m47eus2/m47Board-H503/m47Board-H503.kicad_pcb

## KiCad design m47Board-H503.kicad_pcb (2026-09-05)

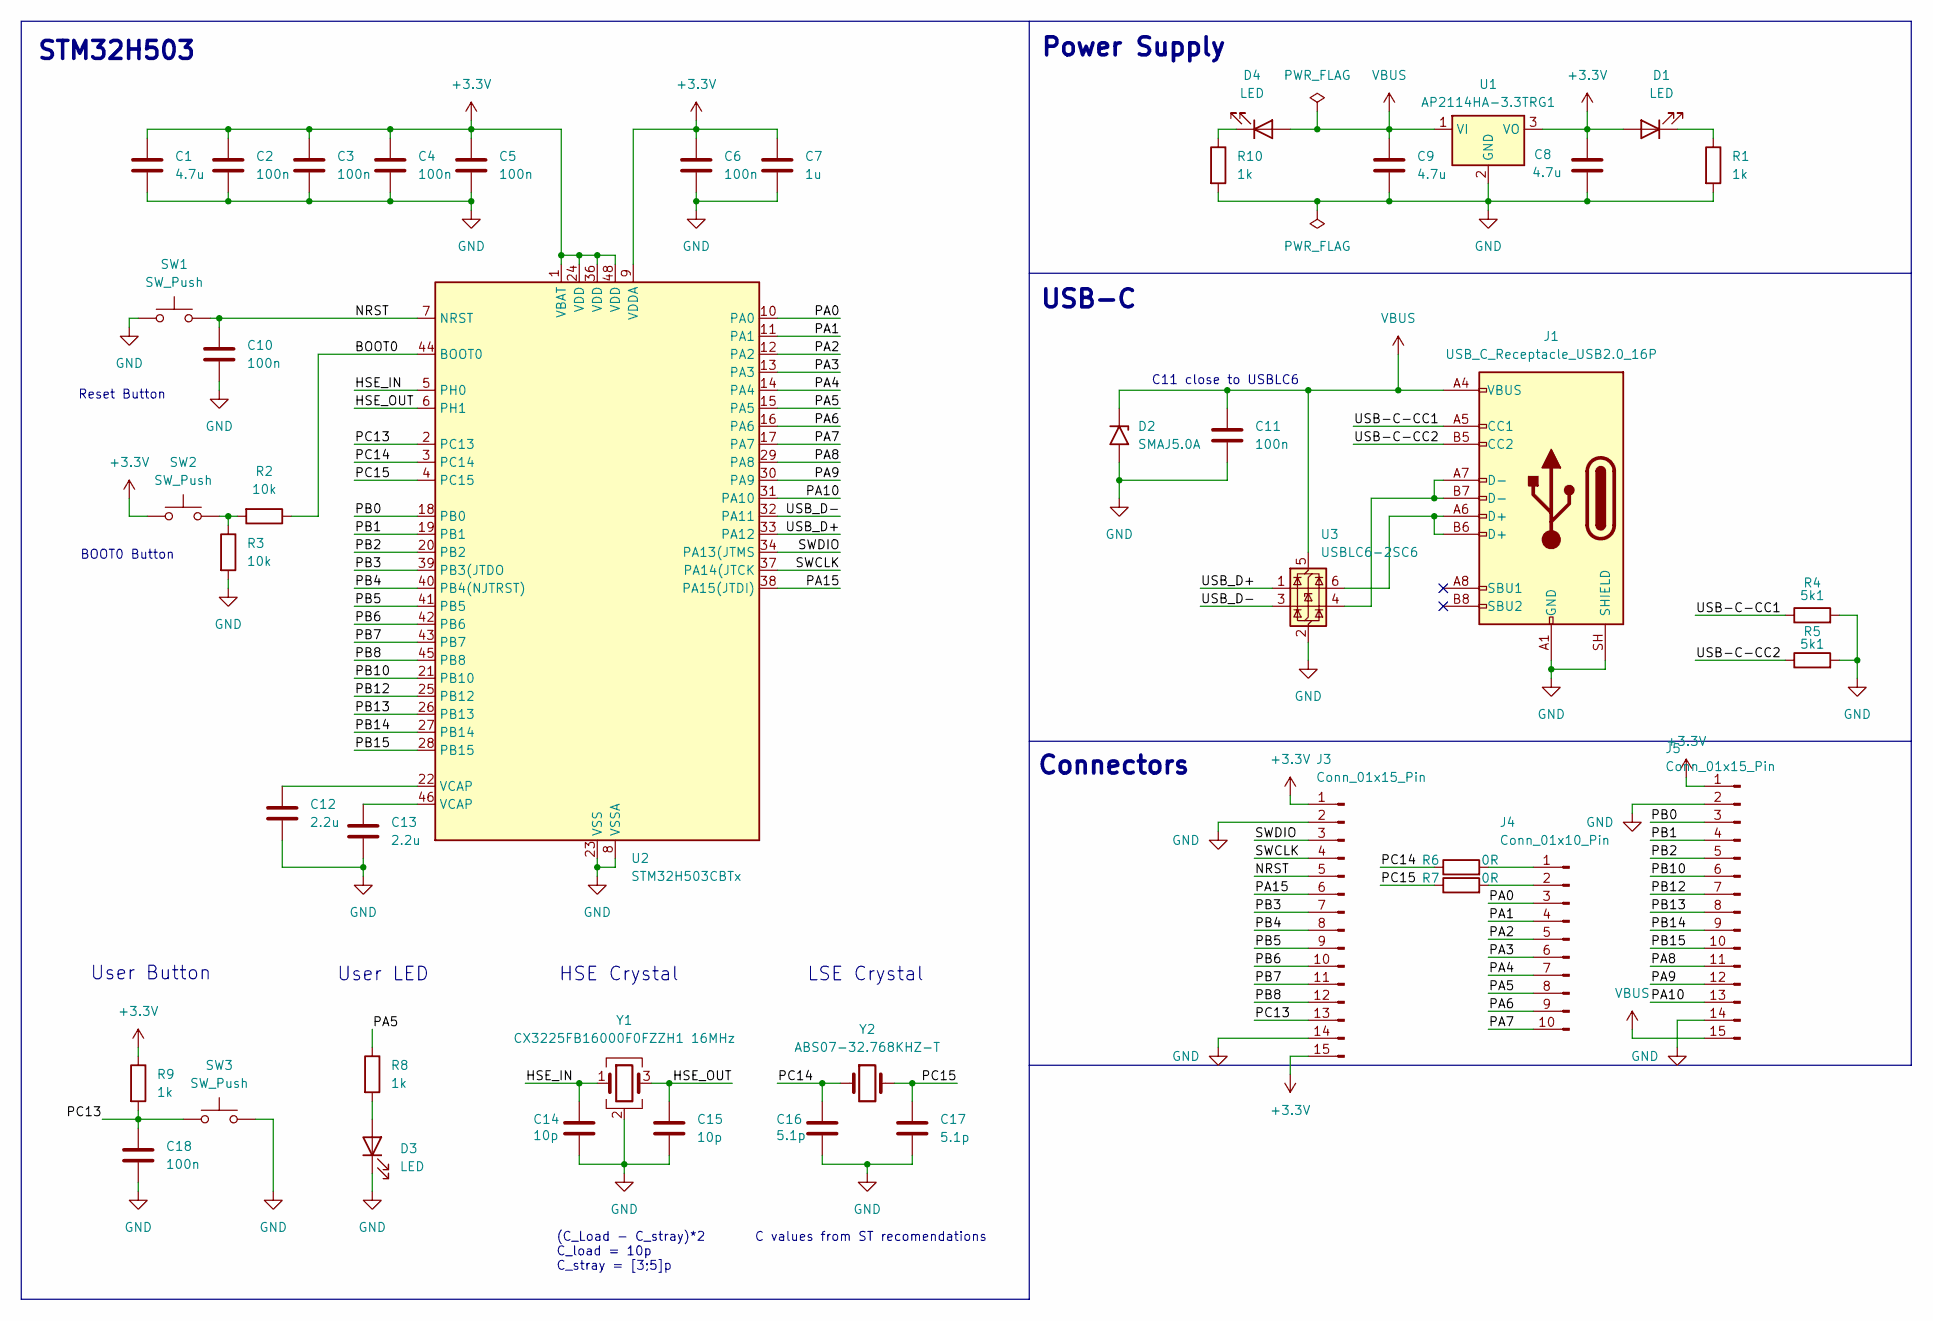
[picture p3: schematic m47Board-H503.kicad_sch]

Parts:
C1, C8, C9: 4.7u; C_0805_2012Metric_Pad1.18x1.45mm_HandSolder
C2, C3, C4, C5, C6, C10, C11, C18: 100n; C_0402_1005Metric_Pad0.74x0.62mm_HandSolder
C7: 1u; C_0603_1608Metric_Pad1.08x0.95mm_HandSolder
C12, C13: 2.2u; C_0603_1608Metric_Pad1.08x0.95mm_HandSolder
C14, C15: 10p; C_0402_1005Metric_Pad0.74x0.62mm_HandSolder
C16, C17: 5.1p; C_0402_1005Metric_Pad0.74x0.62mm_HandSolder
D1, D3, D4: LED; LED_0805_2012Metric_Pad1.15x1.40mm_HandSolder
D2: SMAJ5.0A; D_SMA
J1: USB_C_Receptacle_USB2.0_16P; USB_C_Receptacle_GCT_USB4105-xx-A_16P_TopMnt_Horizontal
J3, J5: Conn_01x15_Pin; PinHeader_1x15_P2.54mm_Vertical
J4: Conn_01x10_Pin; PinHeader_1x10_P2.54mm_Vertical
R1, R8, R9, R10: 1k; R_0402_1005Metric_Pad0.72x0.64mm_HandSolder
R2, R3: 10k; R_0402_1005Metric_Pad0.72x0.64mm_HandSolder
R4, R5: 5k1; R_0402_1005Metric_Pad0.72x0.64mm_HandSolder
R6, R7: 0R; R_0402_1005Metric_Pad0.72x0.64mm_HandSolder
SW1, SW2, SW3: SW_Push; SW_Push_1P1T_NO_E-Switch_TL3301NxxxxxG
U1: AP2114HA-3.3TRG1; SOT-223-3_TabPin2
U2: STM32H503CBTx; LQFP-48_7x7mm_P0.5mm
U3: USBLC6-2SC6; SOT-23-6
Y1: CX3225FB16000F0FZZH1 16MHz; Crystal_SMD_3225-4Pin_3.2x2.5mm
Y2: ABS07-32.768KHZ-T; Crystal_SMD_3215-2Pin_3.2x1.5mm

Connections:
+3.3V: C1.1, C2.1, C3.1, C4.1, C5.1, C6.1, C7.1, C8.1, D1.2 (A), J3.1, J3.15, J5.1, R9.1, SW2.1, U1.3 (VO), U2.1 (VBAT), U2.9 (VDDA), U2.24 (VDD), U2.36 (VDD), U2.48 (VDD)
/BOOT0: R2.1, U2.44 (BOOT0)
/HSE_IN: C14.1, U2.5 (PH0), Y1.1
/HSE_OUT: C15.1, U2.6 (PH1), Y1.3
/NRST: C10.1, J3.5, SW1.2, U2.7 (NRST)
/PA0: J4.3, U2.10 (PA0)
/PA1: J4.4, U2.11 (PA1)
/PA2: J4.5, U2.12 (PA2)
/PA3: J4.6, U2.13 (PA3)
/PA4: J4.7, U2.14 (PA4)
/PA5: J4.8, R8.1, U2.15 (PA5)
/PA6: J4.9, U2.16 (PA6)
/PA7: J4.10, U2.17 (PA7)
/PA8: J5.11, U2.29 (PA8)
/PA9: J5.12, U2.30 (PA9)
/PA10: J5.13, U2.31 (PA10)
/PA15: J3.6, U2.38 (PA15(JTDI))
/PB0: J5.3, U2.18 (PB0)
/PB1: J5.4, U2.19 (PB1)
/PB2: J5.5, U2.20 (PB2)
/PB3: J3.7, U2.39 (PB3(JTDO)
/PB4: J3.8, U2.40 (PB4(NJTRST))
/PB5: J3.9, U2.41 (PB5)
/PB6: J3.10, U2.42 (PB6)
/PB7: J3.11, U2.43 (PB7)
/PB8: J3.12, U2.45 (PB8)
/PB10: J5.6, U2.21 (PB10)
/PB12: J5.7, U2.25 (PB12)
/PB13: J5.8, U2.26 (PB13)
/PB14: J5.9, U2.27 (PB14)
/PB15: J5.10, U2.28 (PB15)
/PC13: C18.1, J3.13, R9.2, SW3.1, U2.2 (PC13)
/PC14: C16.1, R6.1, U2.3 (PC14), Y2.1
/PC15: C17.1, R7.1, U2.4 (PC15), Y2.2
/SWCLK: J3.4, U2.37 (PA14(JTCK)
/SWDIO: J3.3, U2.34 (PA13(JTMS)
/USB-C-CC1: J1.A5 (CC1), R4.1
/USB-C-CC2: J1.B5 (CC2), R5.1
/USB_D+: U2.33 (PA12), U3.1 (I/O1)
/USB_D-: U2.32 (PA11), U3.3 (I/O2)
GND: C1.2, C2.2, C3.2, C4.2, C5.2, C6.2, C7.2, C8.2, C9.2, C10.2, C11.2, C12.2, C13.2, C14.2, C15.2, C16.2, C17.2, C18.2, D2.2 (A2), D3.1 (K), J1.A1 (GND), J1.A12 (GND), J1.B1 (GND), J1.B12 (GND), J1.SH (SHIELD), J3.2, J3.14, J5.2, J5.14, R1.2, R3.2, R4.2, R5.2, R10.2, SW1.1, SW3.2, U1.2 (GND), U2.8 (VSSA), U2.23 (VSS), U2.35 (VSS), U2.47 (VSS), U3.2 (GND), Y1.2 (G), Y1.4 (G)
unnamed: C12.1, U2.22 (VCAP)
unnamed: C13.1, U2.46 (VCAP)
unnamed: D1.1 (K), R1.1
unnamed: D3.2 (A), R8.2
unnamed: D4.1 (K), R10.1
unnamed: J1.A6 (D+), J1.B6 (D+), U3.6 (I/O1)
unnamed: J1.A7 (D-), J1.B7 (D-), U3.4 (I/O2)
unnamed: J4.1, R6.2
unnamed: J4.2, R7.2
unnamed: R2.2, R3.1, SW2.2
VBUS: C9.1, C11.1, D2.1 (A1), D4.2 (A), J1.A4 (VBUS), J1.A9 (VBUS), J1.B4 (VBUS), J1.B9 (VBUS), J5.15, U1.1 (VI), U3.5 (VBUS)

Notes on the sheet:
USB-C
LSE Crystal
Reset Button
User Button
C values from ST recomendations
BOOT0 Button
Power Supply
C11 close to USBLC6
(C_Load - C_stray)*2 C_load = 10p C_stray = [3;5]p
STM32H503
User LED
Connectors
HSE Crystal

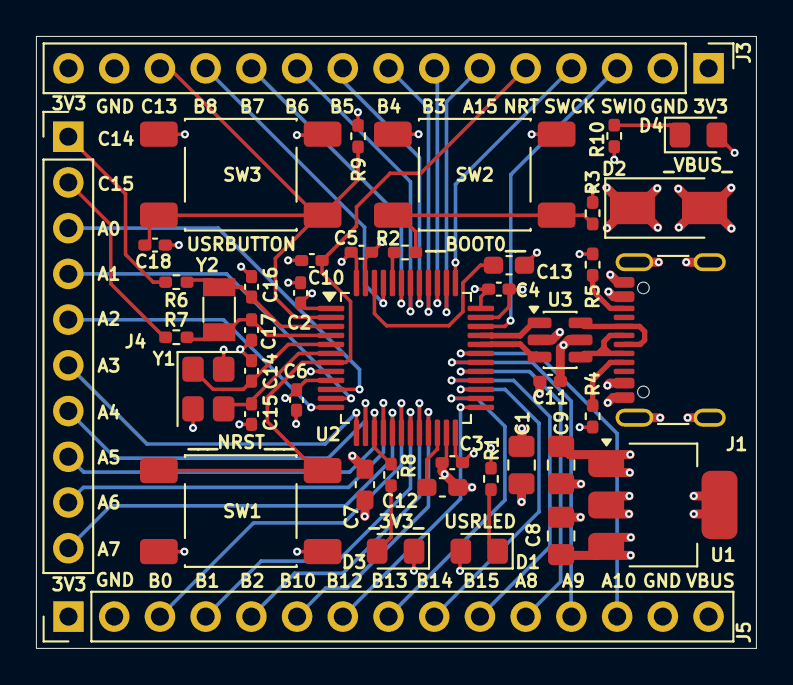
[picture p4: board m47Board-H503.kicad_pcb from above]

Board: 4 copper layers, 40.0 x 34.0 mm, 44 parts (0 on the bottom side), 52 nets.
