m47eus2/m47Board-H503/m47Board-H503.ioc

Mcu.UserName=STM32H503CBTx
PA11.Signal=USB_DM
PA12.Signal=USB_DP
PA13(JTMS/SWDIO).Signal=DEBUG_JTMS-SWDIO
PA14(JTCK/SWCLK).Signal=DEBUG_JTCK-SWCLK
PC14-OSC32_IN(OSC32_IN).Signal=RCC_OSC32_IN
PC15-OSC32_OUT(OSC32_OUT).Signal=RCC_OSC32_OUT
PH0-OSC_IN(PH0).Signal=RCC_OSC_IN
PH1-OSC_OUT(PH1).Signal=RCC_OSC_OUT
