m47eus2/m47Board-H503/(commit log)

2026-06-28 Part of schematic and pinout for m47Board-H503
    [m47Board-H503.kicad_pcb, m47Board-H503.kicad_sch]
2026-06-29 Update m47Board-H503 schematic
    [m47Board-H503.kicad_sch]
2026-07-01 Add USB-C ESD protection to m47Board-H503 schematic
    [m47Board-H503.kicad_sch]
2026-07-01 Add footprints to m47Board-H503 schematic
    [m47Board-H503.kicad_sch]
2026-07-01 Start making m47Board-H503 PCB layout
    [m47Board-H503.kicad_pcb, m47Board-H503.kicad_sch]
2026-07-03 m47Board-H503 PCB layout update
    [m47Board-H503.kicad_pcb, m47Board-H503.kicad_sch]
2026-08-10 Update PCB layout
    [m47Board-H503.kicad_pcb, m47Board-H503.kicad_sch]
2026-08-11 Update PCB layout, start routing traces
    [m47Board-H503.kicad_pcb]
2026-08-11 Route some traces, do some silkscreen, change USB-C symbol, change larger caps footprints to 0603
    [m47Board-H503.kicad_pcb, m47Board-H503.kicad_sch]
2026-08-23 Add net class for usb diff pair
    [m47Board-H503.kicad_pcb]
2026-08-23 Route USB diff pair
    [m47Board-H503.kicad_pcb]
2026-08-23 Add copper zones
    [m47Board-H503.kicad_pcb, m47Board-H503.kicad_sch]
2026-08-23 Route traces
    [m47Board-H503.kicad_pcb, m47Board-H503.kicad_sch]
2026-08-24 Route tracks
    [m47Board-H503.kicad_pcb, m47Board-H503.kicad_sch]
2026-08-31 Route trakcs, arrange silkscreen
    [m47Board-H503.kicad_pcb]
2026-08-31 Refill copper zones
    [m47Board-H503.kicad_pcb]
2026-09-02 Add VBUS LED, clean bottom copper
    [m47Board-H503.kicad_pcb, m47Board-H503.kicad_sch]
2026-09-02 Arrange silkscreen
    [m47Board-H503.kicad_pcb]
2026-09-02 Add QR code to silkscreen
    [m47Board-H503.kicad_pcb]
2026-09-05 Clean DRC
    [m47Board-H503.kicad_pcb]
2026-09-05 Swap LDO, clean DRC
    [m47Board-H503.kicad_pcb, m47Board-H503.kicad_sch]
2026-09-05 Inspect before production, reroute some tracks
    [m47Board-H503.kicad_pcb]
2026-09-05 Add rev to silk, fill tables
    [m47Board-H503.kicad_pcb, m47Board-H503.kicad_sch]
2026-09-05 Move cap
    [m47Board-H503.kicad_pcb]
2026-09-05 Rearrange silk
    [m47Board-H503.kicad_pcb]
2026-09-05 Add bom
2026-09-05 Generate gerbers
    [m47Board-H503-B_Cu.gbr, m47Board-H503-B_Mask.gbr, m47Board-H503-B_Paste.gbr, m47Board-H503-B_Silkscreen.gbr, m47Board-H503-Edge_Cuts.gbr, m47Board-H503-F_Cu.gbr, m47Board-H503-F_Mask.gbr, m47Board-H503-F_Paste.gbr]
2026-11-03 Add schematic to README.md
